John-High-Sierra/sprinkler-8-circuitboard/schematics/SprinKlr8_Board_Design_Brief.docx

SprinKlr-8

8-Zone WiFi Sprinkler Controller

AI CIRCUIT BOARD DESIGN BRIEF

Version 1.0 | May 2026

This document is a complete design brief for the SprinKlr-8 printed circuit board. It specifies every functional block, component, GPIO assignment, power architecture, protection circuit, PCB layout rule, and manufacturing requirement. Design the schematic and PCB layout exactly as specified. Where a choice is not specified, prefer the most reliable and manufacturable option for a commercial product targeting 1,000 units through JLCPCB PCBA.

# 1. Project Overview

SprinKlr-8 is a commercial WiFi-enabled sprinkler controller based on the ESP32 microcontroller. It controls eight 24VAC sprinkler valve solenoids via relay outputs, delivers a browser-based scheduling interface over WiFi, and supports over-the-air (OTA) firmware updates. The board is intended for residential and light commercial irrigation systems.

Field | Value
Product Name | SprinKlr-8
MCU | ESP32-WROOM-32E (38-pin, integrated antenna)
Relay Zones | 8 independent SPST-NO relay outputs for 24VAC solenoid valves
Field Power Input | 24VAC from external transformer — barrel jack (primary) or screw terminal (alternate), user-selectable via on-board jumper
Programming Interface | USB-C (CH340C), auto-reset circuit included
Target Manufacture | JLCPCB PCBA — all SMD components from LCSC catalog
Target Volume | 1,000 units per production run
PCB | 2-layer FR4, 1.6mm, ENIG surface finish
Mounting | Four M3 mounting holes at corners for standoff mounting inside enclosure

# 2. Functional Block Descriptions

The board consists of seven functional blocks. Each is described in full detail below. Design the schematic with these as logical groupings.

## 2.1 Power Supply Block

The board is powered from a 24VAC external transformer — the same transformer used to power the sprinkler valve solenoids. The power supply block converts this AC input to regulated +5V DC (for relay coils, LED drivers, and the CH340C) and +3.3V DC (for the ESP32 and logic).

Power Input Connectors:

- Barrel Jack: Standard 2.1mm centre pin, 5.5mm outer diameter. AC input — the jack is not polarised (24VAC has no polarity). This is the primary power connector for new installations where a dedicated plug-pack transformer is used.
- Screw Terminal: 2-pin, 3.5mm pitch, labelled AC1 and AC2. This allows users to connect the bare wire leads from an existing irrigation transformer. Both terminals are electrically equivalent — 24VAC has no polarity.
- Source Selection Jumper: A 3-pin header (2.54mm pitch) labelled PWR-SEL. Shorting pins 1-2 connects the barrel jack to the AC bus. Shorting pins 2-3 connects the screw terminal to the AC bus. This allows the user to select the active power source. Only one source should be connected at a time. Label the jumper positions clearly on the silkscreen.

WARNING: Both power inputs connect the same AC bus. Never connect both sources simultaneously. Ensure silkscreen labelling and user documentation make this clear.

AC to DC Conversion:

- Full-wave bridge rectifier: Use a MB10F SMD bridge rectifier (LCSC: C441951 or equivalent). Rated 1A, 1000V. Input: 24VAC. Output: approximately +33V DC (peak of 24VAC x 1.414 = 33.9V).
- Filter capacitor: 470 µF, 50V electrolytic (radial, SMD or through-hole depending on availability). Place as close as possible to the rectifier output.
- Inrush protection: 5A polyfuse (resettable fuse) on the AC input line before the bridge rectifier to protect against fault conditions.

+5V DC Rail (Buck Converter):

A linear regulator cannot efficiently step down from ~33V DC to 5V at any meaningful current — the power dissipation would be excessive and would require heatsinking. Use a buck (switching) converter.

- IC: MP2307DN or equivalent buck converter. Input up to 23V — STOP. The rectified 24VAC peak is approximately 34V. Use a buck converter rated for at least 40V input. Recommended: LM2596S-5.0 (input up to 40V, fixed 5V output, 3A, LCSC: C2621). Alternatively use the adjustable LM2596S-ADJ set to 5V output.
- Output: 5.0V regulated DC, minimum 1A capacity.
- Inductor: 100 µH per LM2596 datasheet (through-hole or SMD — use whatever JLCPCB can assemble).
- Output capacitor: 220 µF electrolytic.
- Catch diode: 1N5822 Schottky (3A, 40V) or LCSC equivalent.

+3.3V DC Rail (Linear Regulator):

- IC: AMS1117-3.3 SOT-223 package (LCSC: C6186).
- Input: +5V rail from buck converter.
- Output: 3.3V regulated DC for ESP32 and all logic signals.
- Input capacitor: 10 µF ceramic.
- Output capacitor: 22 µF ceramic.

NOTE: The 24VAC supply from the transformer ALSO connects to the relay contact Common terminal (see Section 2.4). The relay contacts switch the 24VAC to the solenoid valves. This is separate from the board power supply — the 24VAC is both the power source for board electronics AND the switching voltage for the valves.

## 2.2 Microcontroller (ESP32-WROOM-32E)

The ESP32-WROOM-32E is a module with the ESP32 chip, flash memory, and PCB antenna integrated. Mount it on the board using its castellated edge pads.

- Module: ESP32-WROOM-32E, 38-pin, 4MB flash minimum. LCSC: C701341 or equivalent.
- Power: +3.3V supply to VCC pins. Decouple with 10 µF + 100 nF ceramic capacitors as close as possible to the module power pins.
- Enable pin (EN): Pull up to 3.3V via 10 kΩ resistor. Connect a normally-open push button from EN to GND labelled "RST" on the silkscreen.
- Boot mode pin (IO0): Pull up to 3.3V via 10 kΩ resistor. Connect a normally-open push button from IO0 to GND labelled "BOOT" on the silkscreen. IO0 = LOW during reset enters bootloader mode for programming.
- GPIO12 (strapping pin): CRITICAL — connect a 10 kΩ resistor from GPIO12 to GND. GPIO12 must be LOW at boot or the ESP32 will fail to start if SDIO voltage selection is triggered. This is non-negotiable.
- Antenna keep-out: Maintain a copper-free zone of at least 15mm around the on-module PCB antenna area. No copper pours, traces, or components under the antenna.

GPIO Assignments — do not deviate from this mapping:

GPIO | Function | Notes
GPIO32 | Relay Zone 1 | Output → ULN2803A input 1
GPIO33 | Relay Zone 2 | Output → ULN2803A input 2
GPIO25 | Relay Zone 3 | Output → ULN2803A input 3
GPIO26 | Relay Zone 4 | Output → ULN2803A input 4
GPIO27 | Relay Zone 5 | Output → ULN2803A input 5
GPIO14 | Relay Zone 6 | Output → ULN2803A input 6
GPIO12 | Relay Zone 7 | Output → ULN2803A input 7. ALSO has 10kΩ pull-down to GND (strapping pin)
GPIO13 | Relay Zone 8 | Output → ULN2803A input 8
GPIO23 | Status LED | Output → LED + 330Ω resistor to GND. Active HIGH.
GPIO1 (TX0) | UART TX | → CH340C RXD
GPIO3 (RX0) | UART RX | ← CH340C TXD
GPIO0 (IO0) | Boot select | 10kΩ pull-up. Boot button to GND. CH340C auto-reset circuit.
EN | Reset | 10kΩ pull-up. Reset button to GND. CH340C auto-reset circuit.

## 2.3 USB-C Programming Interface (CH340C)

The CH340C provides USB-to-UART conversion for programming and serial monitoring. It has an internal oscillator so no external crystal is needed — do not add a crystal.

- IC: CH340C SOP-16 package. LCSC: C84681.
- USB Connector: USB Type-C receptacle, 16-pin SMD. LCSC: C165948 or equivalent.
- CC1 and CC2 pins on the USB-C connector: Connect each to GND through a 5.1 kΩ resistor. This is mandatory for USB-C power delivery specification compliance and tells the host that the device is a standard downstream device. Without these resistors, many USB-C hosts will not supply power.
- USB ESD Protection: Place a USBLC6-2SC6 (SOT-23-6, LCSC: C2827693) between the USB-C connector D+/D- pins and the CH340C USB pins. This protects against electrostatic discharge on the USB connector.
- VBUS polyfuse: 500mA resettable polyfuse (PTC) in series with the USB VBUS line before the +5V bus. LCSC: C386618 or equivalent. This protects the board if the USB host limits current.
- Decoupling: 100 nF ceramic capacitor from CH340C VCC to GND, placed as close as possible to the IC power pin.

Auto-Reset Circuit (for programming without manual button pressing):

Arduino IDE and esptool automatically reset the ESP32 into bootloader mode before uploading. Two NPN transistors implement this using the CH340C DTR and RTS signals.

- Q1: MMBT3904 NPN transistor (SOT-23). Base connected to CH340C RTS pin through 10 kΩ resistor. Collector connected to ESP32 EN pin. Emitter to GND.
- Q2: MMBT3904 NPN transistor (SOT-23). Base connected to CH340C DTR pin through 10 kΩ resistor. Collector connected to ESP32 IO0 pin. Emitter to GND.
- 100 nF capacitors from each transistor base to GND for noise suppression.

NOTE: This is the standard CH340-based auto-reset circuit used on ESP32 development boards such as the AZ-Delivery ESP32 DevKit. Replicate that circuit exactly.

## 2.4 Relay Driver and Relay Block

Eight SPST-NO relays switch 24VAC to the solenoid valve zones. A ULN2803A Darlington array drives the relay coils from the ESP32 GPIOs. The relay logic is ACTIVE HIGH — relay turns ON when the GPIO is driven HIGH.

Relay Driver IC:

- IC: ULN2803A, SOP-18 package. LCSC: C56026. This is an 8-channel Darlington array with internal flyback (freewheeling) diodes. It can sink up to 500mA per channel.
- Input pins 1-8: Connect to ESP32 GPIO32, 33, 25, 26, 27, 14, 12, 13 respectively. No additional pull-down needed — the ULN2803A inputs are internally clamped.
- COM pin (pin 9): Connect to +5V. This is the flyback diode return rail. It must be connected to the relay coil supply voltage for the internal diodes to clamp coil voltage spikes. CRITICAL — do not leave this pin floating.
- Output pins (collector outputs): Connect to the relay coil negative terminal. The ULN2803A sinks current when input is HIGH.
- GND pin: Connect to board GND.

Relay:

- Part: HF46F-G/5-HS1. SMD relay, SPST-NO, 5V coil, 5A/250VAC contact rating. LCSC: C165255. This is a G5NB-compatible SMD footprint.
- Coil positive terminal: Connect to +5V rail.
- Coil negative terminal: Connect to the corresponding ULN2803A collector output.
- Contact terminals: COM contact connects to the 24VAC Common bus terminal. NO contact connects to the corresponding zone screw terminal.

WARNING: Use exactly LCSC part C165255 (HF46F-G/5-HS1). Do not substitute C128511 (this is a capacitor) or C22363895 (this is a through-hole relay). These are incorrect parts with the same search name.

Zone Output Screw Terminals:

- 8 x 2-pin screw terminal blocks, 3.5mm pitch, rated for 10A/300V. LCSC: C8465 or equivalent. One per relay zone. Label Z1 through Z8 on silkscreen.
- 1 x 2-pin screw terminal block (same type) for the 24VAC Common connection. Label COM on silkscreen. This connects the 24VAC power bus to the relay contact COM terminals.

NOTE: Total screw terminal count: 9 blocks of 2 pins = 18 terminals. Arrange them in a row along one edge of the board for clean wiring. Consider using a 10-pin or two 5-pin blocks if footprint is tighter.

Per-Zone Indicator LEDs:

- 8 x red SMD LEDs (0805 package). One per zone. LCSC: C84256 or equivalent red LED.
- Each LED is connected between the relay coil positive terminal (+5V) and the ULN2803A collector output for that zone, in series with a 470 Ω resistor (0805). When the ULN2803A pulls the collector low (relay ON), current flows through the resistor and LED, illuminating it.
- Place each LED adjacent to its corresponding relay on the PCB for intuitive visual identification.
- LED colour: Zone LEDs = RED. Status LED (GPIO23) = GREEN (see Section 2.5).

## 2.5 Status LED

- 1 x green SMD LED (0805 package). LCSC: C72043 or equivalent.
- Connected from GPIO23 through a 330 Ω resistor (0805) to GND. Active HIGH — LED lights when GPIO23 is driven HIGH.
- Place near the edge of the board or near the ESP32 module. Label "STATUS" on silkscreen.

## 2.6 Relay Output Protection (MOV Snubbers)

Sprinkler solenoid valves are inductive loads. When the relay opens (valve turns off), the collapsing magnetic field in the solenoid coil generates a voltage spike that can exceed 100V, damaging relay contacts over time and causing radiated EMI. Each relay output must be protected.

- Protection device: Metal Oxide Varistor (MOV) rated for 34V AC / 48V DC clamping. Suitable part: TVR05470 (47V, 0.1W, 5mm disc). LCSC equivalent or similar — search LCSC for MOV 47V or 40V disc.
- Connection: Solder the MOV across the relay NO output screw terminal and the COM terminal — i.e., directly across the 24VAC solenoid load. One per zone = 8 MOVs total.
- Alternatively, RC snubbers (100 Ω + 10 nF in series across the contacts) are acceptable if MOVs are unavailable from LCSC. Both can be used together for extra protection.

NOTE: MOVs on the relay contacts protect against load-side spikes. The ULN2803A internal flyback diodes protect against coil-side spikes on the 5V rail. Both types of protection are present in this design.

## 2.7 Miscellaneous Connectors and Components

Mounting Holes:

- Four M3 plated through-hole mounting holes, one at each corner of the board. Minimum clearance of 5mm from all traces and copper. Use standard M3 hole diameter (3.2mm) with a 6.5mm annular copper ring.

Decoupling Capacitors:

- Place 100 nF ceramic decoupling capacitors (0402 or 0603) on the power supply pins of every IC — CH340C, ULN2803A, and AMS1117. Place physically as close to each IC power pin as possible.

Test Points:

- Expose test points (THT or SMD pads labelled with net names) for: +5V rail, +3.3V rail, GND, ESP32 TX, ESP32 RX, and USB VBUS. Useful during bring-up.

# 3. Bill of Materials

All components must be available on LCSC and preferably classified as "Basic" parts to minimise JLCPCB extended component fees. LCSC part numbers are provided where confirmed correct. Verify all part numbers in EasyEDA/LCSC before ordering.

Component / Description | LCSC Part | Package | Qty | Notes
ESP32-WROOM-32E | C701341 | Module | 1 | 4MB flash minimum
CH340C USB-UART | C84681 | SOP-16 | 1 | Internal oscillator, no crystal needed
AMS1117-3.3 LDO | C6186 | SOT-223 | 1 | 3.3V regulator
LM2596S-5.0 Buck Converter | C2621 | TO-263-5 | 1 | 5V/3A, 40V input max
MB10F Bridge Rectifier | C441951 | MBS | 1 | 1A, 1000V SMD bridge
ULN2803A Darlington Array | C56026 | SOP-18 | 1 | 8-ch, internal flyback diodes
HF46F-G/5-HS1 Relay, 5V SMD | C165255 | SMD | 8 | SPST-NO, 5A/250VAC, G5NB footprint
USBLC6-2SC6 USB ESD Protection | C2827693 | SOT-23-6 | 1 | On USB D+/D- lines
MMBT3904 NPN Transistor | C20526 | SOT-23 | 2 | Auto-reset circuit (DTR/RTS)
USB Type-C Receptacle 16-pin | C165948 | SMD | 1 | Verify footprint in EasyEDA
Barrel Jack 2.1mm/5.5mm | Verify on LCSC | THT | 1 | 24VAC primary power input
2-pin Screw Terminal 3.5mm | C8465 | THT | 9 | 8 zone outputs + 1 COM
2-pin Screw Terminal 3.5mm | C8465 | THT | 1 | Alternate 24VAC input from screw
3-pin Header 2.54mm (PWR-SEL) | Standard | THT | 1 | Power source selection jumper
MOV 47V disc (per-zone protection) | Verify on LCSC | Disc 5mm | 8 | Across relay NO and COM output
Red LED 0805 | C84256 | 0805 | 8 | Per-zone relay indicators
Green LED 0805 | C72043 | 0805 | 1 | System status (GPIO23)
470 Ω Resistor 0805 | Basic | 0805 | 8 | Zone LED current limit
330 Ω Resistor 0805 | Basic | 0805 | 1 | Status LED current limit
10 kΩ Resistor 0402 | Basic | 0402 | 8 | Pull-ups (EN, IO0) + GPIO12 pull-down + auto-reset bases
100 nF Ceramic Cap 0402 | Basic | 0402 | 10 | Decoupling on all IC power pins
10 µF Ceramic Cap 0603 | Basic | 0603 | 3 | AMS1117 input/output, ESP32 power
470 µF Electrolytic 50V | Verify on LCSC | Radial | 1 | Bulk filter cap after bridge rectifier
220 µF Electrolytic 10V | Verify on LCSC | Radial | 1 | LM2596 output filter cap
100 µH Inductor | Verify on LCSC | SMD or THT | 1 | LM2596 switching inductor, rated 1A+
1N5822 Schottky Diode | Verify on LCSC | DO-201AD or SMD | 1 | LM2596 catch diode
5.1 kΩ Resistor 0402 | Basic | 0402 | 2 | USB-C CC1 and CC2 to GND
500mA PTC Polyfuse | C386618 | 0805 | 1 | USB VBUS protection
5A PTC Polyfuse (AC input) | Verify on LCSC | THT or SMD | 1 | AC line protection before bridge rectifier
BOOT Push Button (6mm) | C318884 | THT | 1 | IO0 to GND
RST Push Button (6mm) | C318884 | THT | 1 | EN to GND

# 4. PCB Layout Rules and Guidelines

Follow these rules strictly. They are based on electrical performance requirements, safety standards, and JLCPCB manufacturing capabilities.

## 4.1 Board Specifications

- Layers: 2 (top copper + bottom copper)
- Board material: FR4
- Thickness: 1.6mm
- Surface finish: ENIG (Electroless Nickel Immersion Gold) — required for a commercial product. Better solderability and longer shelf life than HASL.
- Minimum trace width: 0.15mm (JLCPCB standard). Use wider traces wherever possible.
- Minimum via: 0.3mm drill, 0.6mm pad (JLCPCB standard).
- Copper weight: 1oz top and bottom.
- Solder mask: Green (standard). Both sides.
- Silkscreen: White both sides. Include all component reference designators, pin 1 markers, connector labels (Z1-Z8, COM, AC1, AC2), and a board revision/version number.

## 4.2 Board Size

The board must accommodate the ESP32 module (18mm x 25.5mm), 8 relays, 9 screw terminal blocks, power supply section, and USB connector. Estimated minimum board size is 100mm x 80mm. Adjust as needed to fit all components comfortably with required clearances. Target a board size that will fit in a standard ABS project enclosure (e.g., 130mm x 100mm x 40mm internal).

## 4.3 Component Placement

- ESP32 module: Top side. Orient antenna toward a board edge with no copper within 15mm of the antenna. Do not place it in a corner — the antenna must face away from the power section.
- Relay block: Group all 8 relays together in two rows of 4. Place close to the screw terminal edge.
- Screw terminals: Along one long edge of the board (the "field wiring" edge). Zone terminals Z1-Z8 in order, followed by COM. The alternate 24VAC input screw terminal can be near the barrel jack on the "power" edge.
- Power supply block (bridge rectifier, LM2596, AMS1117): Opposite edge from the relay/terminal side. Keep high-voltage AC traces short and away from the ESP32 and USB section.
- USB-C connector: On the short edge of the board, accessible from outside an enclosure.
- BOOT and RST buttons: Near the ESP32 module, accessible without tools.
- Zone LEDs: Adjacent to their corresponding relay. Oriented consistently (all anode to +5V side).
- Status LED: Near the ESP32 module, near the board edge for visibility.
- ULN2803A: Between the ESP32 GPIO outputs and the relay coils. Place centrally in the relay block area.
- MOVs: As close as possible to the screw terminal output connections.

## 4.4 Trace Widths

Net / Signal | Min Width | Notes
24VAC input (before rectifier) | 1.5mm | Mains AC potential
Relay contact traces (COM, zone outputs) | 1.5mm | 5A rated — keep as short as possible
+5V power bus | 0.8mm | Up to 1A
+3.3V power bus | 0.5mm | ESP32 supply
GND pour (plane) | Copper fill | Flood fill on both layers
GPIO signal traces (relay control) | 0.25mm | Low current logic
USB data lines (D+, D-) | 0.2mm | Match impedance, keep equal length, keep short
UART (TX/RX) | 0.2mm | Keep away from switching supply

## 4.5 Clearances

- Minimum clearance between AC traces (24VAC section) and all low-voltage DC traces: 3mm. This is a safety isolation requirement.
- Relay contact side (NO terminal traces carrying 24VAC) to DC logic traces: 3mm minimum clearance.
- General PCB design rule clearance (non-HV): 0.2mm minimum (JLCPCB capability is 0.127mm but use 0.2mm for reliability).
- Mounting hole copper clearance: 5mm from all traces.
- Board edge clearance: minimum 0.3mm for all copper, 0.5mm for components.

## 4.6 Copper Pour / Ground Plane

- Flood fill GND on both top and bottom copper layers.
- Stitch top and bottom GND pours together with via stitching (multiple vias around the perimeter and under large copper areas).
- Do NOT flood fill GND under the ESP32 antenna area. Keep that zone copper-free.
- Separate the AC power section ground from the DC logic ground — use a single connection point (star ground) between the two to prevent AC noise coupling into the logic section.

## 4.7 Switching Power Supply Layout (LM2596)

- Keep the switching loop (LM2596 output pin → catch diode → inductor → output capacitor → GND back to IC) as tight and short as possible. Switching current loops must be minimised to reduce EMI.
- Place the catch diode directly adjacent to the LM2596 output pin.
- Place the inductor and output capacitor close together.
- Do not route sensitive signal traces (UART, USB, GPIO) near the LM2596 switching loop.

# 5. Manufacturing Requirements (JLCPCB PCBA)

## 5.1 File Outputs Required

- Gerber files (RS-274X format): All copper layers, solder mask, silkscreen, board outline, drill.
- Drill file: Excellon format, with separate PTH and NPTH files if applicable.
- BOM CSV: Component reference, LCSC part number, quantity, footprint, value. Format must match JLCPCB BOM template.
- Pick and Place CSV (CPL): Component reference, centre X, centre Y, rotation, layer. Format must match JLCPCB CPL template.

## 5.2 JLCPCB PCBA Notes

- All components specified as SMD should be on the TOP side of the board where possible to avoid double-sided assembly surcharges.
- Through-hole components (screw terminals, barrel jack, push buttons, electrolytic capacitors, inductors) may be excluded from PCBA and hand-assembled after reflow. Flag these clearly in the BOM.
- Use LCSC "Basic" parts wherever possible. Extended parts add a $3 setup fee per part type. Check LCSC classification before finalising BOM.
- Verify all component footprints against LCSC datasheet mechanical drawings before submitting. Incorrect footprints are the most common cause of PCBA rework.
- Include fiducial marks (3 minimum) on the top copper layer for pick-and-place alignment.
- JLCPCB minimum order for PCBA is typically 5 boards — order 5 for initial prototyping.

## 5.3 Prototype Verification Sequence

1. Power on with USB only (no 24VAC). Confirm 3.3V and 5V rails are present. Check CH340C is detected by a PC as a COM port.
2. Flash relay_pin_finder firmware via Arduino IDE. Confirm each GPIO activates the correct relay in sequence (GPIO32=zone1 through GPIO13=zone8).
3. Connect 24VAC. Confirm bridge rectifier output is approximately 30-34V DC. Confirm LM2596 output is 5.0V. Confirm AMS1117 output is 3.3V.
4. Flash main sprinkler_controller firmware. Confirm WiFi AP "SprinklerSetup" appears. Configure WiFi. Confirm board connects and web interface loads at http://sprinkler.local.
5. Test each zone from the web interface. Confirm zone LED illuminates and relay clicks.
6. Verify mDNS is working (http://sprinkler.local resolves without IP address).

# 6. Firmware Context (For Reference Only)

The firmware is pre-written and is not part of this design brief. The following information is provided so the board designer understands the software environment and can verify the hardware supports it correctly.

- Platform: Arduino IDE 2.x with ESP32 Arduino core (Espressif).
- Libraries: WiFiManager (tzapu), ArduinoJson (bblanchon), NTPClient (Weinberg), ESPAsyncWebServer, LittleFS.
- WiFi provisioning: Captive portal via WiFiManager. SSID: "SprinklerSetup". After provisioning, connects to user WiFi.
- Web interface: Served from LittleFS (internal flash filesystem). Single-page app, mobile-optimised, dark theme.
- mDNS: Board advertises as "sprinkler.local" using ESPmDNS library. Reachable at http://sprinkler.local without knowing the IP address.
- OTA updates: Arduino OTA and HTTP OTA from GitHub releases.
- Relay logic: ACTIVE HIGH. GPIO HIGH = relay coil energised = valve ON.
- All 8 relay GPIO pins are confirmed in firmware as: GPIO32, 33, 25, 26, 27, 14, 12, 13 for zones 1-8.
- Status LED on GPIO23: slow heartbeat when idle, fast blink when a zone is running.

# 7. Design Intent Summary

This section summarises the intent behind key design decisions for the benefit of the AI designer.

Decision | Rationale
24VAC power input (not 5V/12V DC) | Residential sprinkler systems already have a 24VAC transformer. Using the existing transformer reduces installation cost and complexity for the end user.
Barrel jack + screw terminal with jumper | New installations use a small plug-pack transformer into the barrel jack. Users replacing an existing controller can reuse their existing wired transformer via screw terminals. The jumper prevents both being active simultaneously.
USB-C with auto-reset | Modern connector. Auto-reset eliminates the need for the user to manually hold buttons during firmware flashing — critical for a non-technical end user. Developer-friendly.
ULN2803A + HF46F-G relay (not solid state) | Mechanical relays provide hard galvanic isolation between 24VAC and ESP32 logic. Simple, robust, low-cost, and compatible with inductive solenoid loads.
MOV output protection | Solenoid valve coils are inductive. Without protection, the back-EMF spike when a valve turns off can damage relay contacts over hundreds of cycles and cause radiated interference.
Per-zone red LEDs | Instant visual feedback during installation and troubleshooting. An installer can see which zone is firing without a phone or web browser.
GPIO12 pull-down resistor | GPIO12 is the ESP32 SDIO voltage strapping pin. If high at boot, the chip selects a different flash voltage and may fail to start. The 10kΩ pull-down ensures reliable boot in all conditions.
LM2596 buck converter (not linear) | Stepping 34V DC down to 5V with a linear regulator would dissipate ~29V at whatever current the board draws — generating significant heat and requiring a heatsink. The switching converter is >80% efficient and stays cool.
M3 mounting holes at corners | Board will be mounted inside an ABS plastic enclosure on nylon or brass standoffs. Screw mounting is standard for commercial enclosures and provides mechanical stability and vibration resistance.

End of Design Brief

For firmware, web UI, and product documentation, refer to the SprinKlr-8 project repository.

SprinKlr-8 PCB Design Brief | Rev 1.0 | 2026 Page

SprinKlr-8 | AI Board Design Brief CONFIDENTIAL
