John-High-Sierra/sprinkler-8-circuitboard/hardware/Rev0.2/SprinKlr-8 Rev1.1/SprinKlr-8 Rev1.1/3D RENDER/SprinKlr-8 Rev1.0.pdf

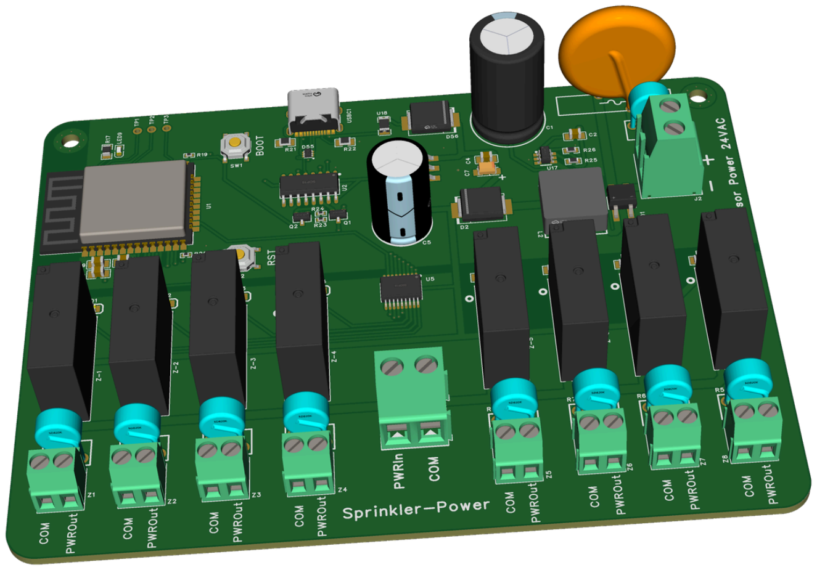
[picture p1: page 1]
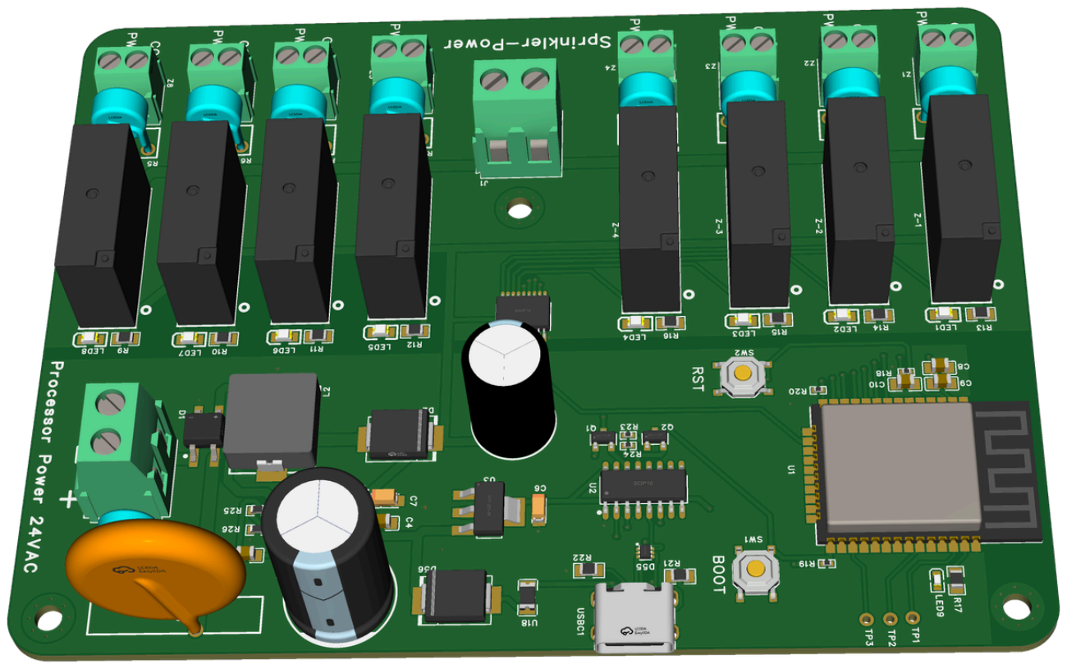
[picture p2: page 2]
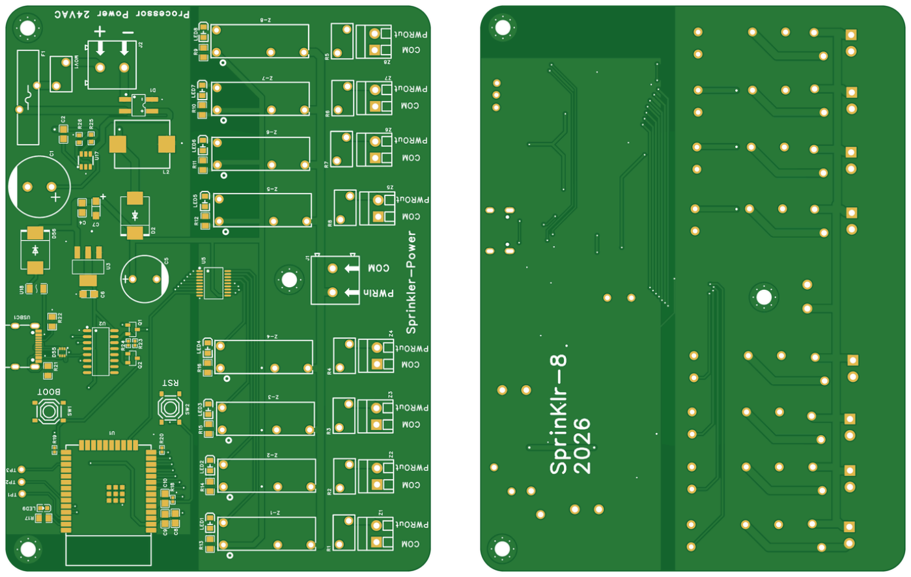
[picture p3: page 3]
