John-High-Sierra/sprinkler-8-circuitboard/schematics/Rough Arrangement.jpg

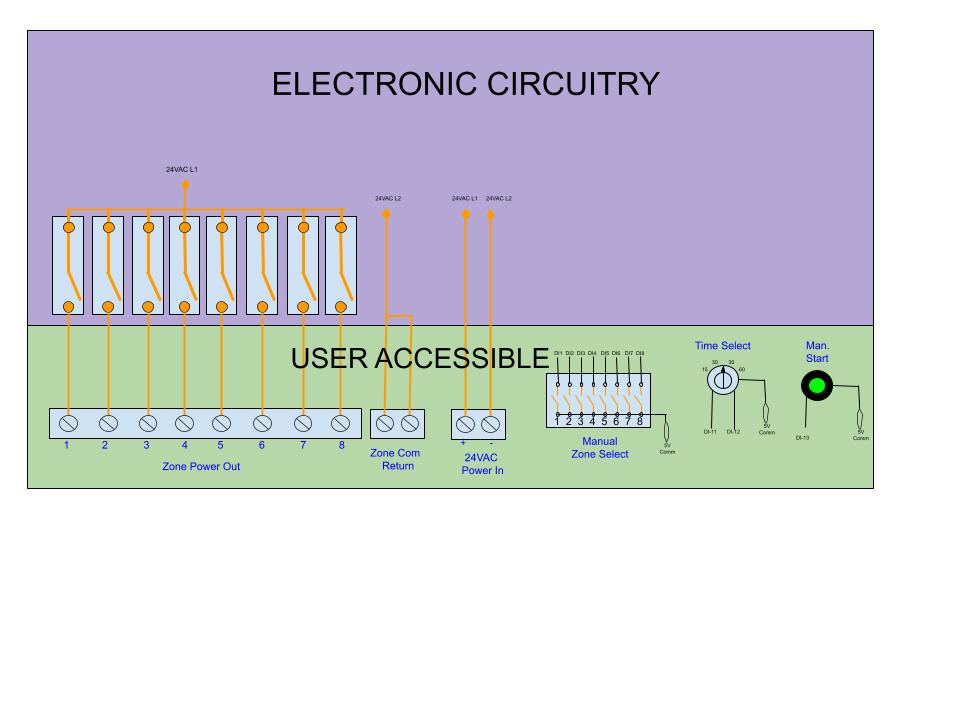
schematics/Rough Arrangement.jpg
