John-High-Sierra/sprinkler-8-circuitboard/hardware/Rev0.2/SprinKlr-8 Rev1.1/SprinKlr-8 Rev1.1/BOM/BOM.csv

No. | Quantity | Comment | Designator | Footprint | Value | Manufacturer Part | Manufacturer | Supplier Part | Supplier
1 | 1 | 470uF | C1 | CAP-TH_BD13.0-P5.00-D1.2-FD | 470uF | ERF1HM471K16OT | AISHI(艾华集团) | C106527 | LCSC
2 | 4 | 100nF | C2,C4,C9,C10 | C0805 | 100nF | CL21B104KCFNNNE | SAMSUNG(三星) | C28233 | LCSC
3 | 1 | 220uF | C5 | CAP-TH_BD10.0-P5.00-D1.0-FD | 220uF | SHG220UF50V01EC1210 | KNSCHA(科尼盛) | C3034843 | LCSC
4 | 1 | 22uF | C6 | CASE-A_3216 | 22uF | TAJA226K010RNJ | Kyocera AVX | C11366 | LCSC
5 | 1 | 10uF | C7 | CAP-SMD_L3.2-W1.6-RD-C7171 | 10uF | TAJA106K016RNJ | Kyocera AVX | C7171 | LCSC
6 | 1 | 10uF | C8 | C0805 | 10uF | CL21A106KAYNNNE | SAMSUNG(三星) | C15850 | LCSC
7 | 1 | MB210S | D1 | MBS_L4.7-W4.0-P2.50-LS7.0-BL |  | MB210S | 晶导微电子 | C382839 | LCSC
8 | 2 | SS35 | D2,D56 | SMC_L6.9-W5.9-LS7.9-RD |  | SS35 | onsemi(安森美) | C719834 | LCSC
9 | 1 | USBLC6-2P6 | D55 | SOT-666-6_L1.6-W1.2-P0.50-LS1.6-BL |  | USBLC6-2P6 | TECH PUBLIC(台舟) | C2827693 | LCSC
10 | 1 | RL250-800 | F1 | FUSE-TH_L20.0-W4.5-P5.10-D0.8-S3.70 |  | RL250-800 | RUILON(瑞隆源) | C20866 | LCSC
11 | 2 | WJ500V-5.08-2P | J1,J2 | CONN-TH_2P-P5.00_WJ500V-5.08-2P |  | WJ500V-5.08-2P | KANGNEX(康奈克斯电气) | C8465 | LCSC
12 | 1 | 100uH | L2 | IND-SMD_L11.5-W10.0 | 100uH | PSPMAA1050H-101M-ANP | PROD(谱罗德) | C5273830 | LCSC
13 | 8 | NCD0805R1 | LED1,LED2,LED3,LED4,LED5,LED6,LED7,LED8 | LED0805-RD |  | NCD0805R1 | 国星光电 | C84256 | LCSC
14 | 1 | 19-217/GHC-YR1S2/3T | LED9 | LED0603-RD |  | 19-217/GHC-YR1S2/3T | EVERLIGHT(亿光) | C72043 | LCSC
15 | 9 | 250pF@1kHz | MOV1,R1,R2,R3,R4,R5,R6,R7,R8 | RES-TH_L7.5-W4.6-P5.00-D1.2-S2.00 | 250pF@1kHz | STE05D101K1BN0FSB0R0 | STE(松田) | C362788 | LCSC
16 | 2 | MMBT3904 | Q1,Q2 | SOT-23-3_L2.9-W1.3-P1.90-LS2.4-BR |  | MMBT3904 | CJ(江苏长电/长晶) | C20526 | LCSC
17 | 8 | 470Ω | R9,R10,R11,R12,R13,R14,R15,R16 | R0805 | 470Ω | 0805W8F4700T5E | UNI-ROYAL(厚声) | C17710 | LCSC
18 | 1 | 330Ω | R17 | R0805 | 330Ω | 0805W8F3300T5E | UNI-ROYAL(厚声) | C17630 | LCSC
19 | 5 | 10kΩ | R18,R19,R20,R23,R24 | R0402 | 10kΩ | 0402WGF1002TCE | UNI-ROYAL(厚声) | C25744 | LCSC
20 | 2 | 5.1kΩ | R21,R22 | R0805 | 5.1kΩ | 0805W8F5101T5E | UNI-ROYAL(厚声) | C27834 | LCSC
21 | 1 | 43kΩ | R25 | R0603 | 43kΩ | FRC0603F4302TS | FOJAN(富捷) | C2907038 | LCSC
22 | 1 | 13kΩ | R26 | R0603 | 13kΩ | FRC0603F1302TS | FOJAN(富捷) | C2906992 | LCSC
23 | 2 | TS-1187A-B-A-B | SW1,SW2 | SW-SMD_4P-L5.1-W5.1-P3.70-LS6.5-TL_H1.5 |  | TS-1187A-B-A-B | XKB Connection(中国星坤) | C318884 | LCSC
24 | 1 | 2.4GHz | U1 | WIFI-SMD_ESP32-WROOM-32E | 2.4GHz | ESP32-WROOM-32E-N4 | ESPRESSIF(乐鑫) | C701341 | LCSC
25 | 1 | CH340C | U2 | SOP-16_L10.0-W3.9-P1.27-LS6.0-BL |  | CH340C | WCH(南京沁恒) | C84681 | LCSC
26 | 1 | AMS1117-3.3 | U3 | SOT-223-3_L6.5-W3.4-P2.30-LS7.0-BR |  | AMS1117-3.3 | AMS | C6186 | LCSC
27 | 1 | TBD62083AFNG,EL | U5 | SSOP-18_L6.8-W4.4-P0.65-LS6.4-BL |  | TBD62083AFNG,EL | TOSHIBA(东芝) | C163229 | LCSC
28 | 1 | LMR16006XDDCR | U17 | SOT-23-6_L2.9-W1.6-P0.95-LS2.8-BR |  | LMR16006XDDCR | TI(德州仪器) | C87080 | LCSC
29 | 1 | 1206L050/24NRT | U18 | F1206 |  | 1206L050/24NRT | LUTE(陆特) | C28326720 | LCSC
30 | 1 | TYPE-C-31-M-12 | USBC1 | USB-C_SMD-TYPE-C-31-M-12_1 |  | TYPE-C-31-M-12 | 韩国韩荣 | C165948 | LCSC
31 | 8 | DB125-3.5-2P-GN-S | Z1,Z2,Z3,Z4,Z5,Z6,Z7,Z8 | CONN-TH_2P-P3.50_L7.4-W7.0 |  | DB125-3.5-2P-GN-S | DORABO(地博电气) | C466970 | LCSC
32 | 8 | HF46F-G/5-HS1 | Z-1,Z-2,Z-3,Z-4,Z-5,Z-6,Z-7,Z-8 | RELAYS-TH_HF46F-G-XX-HS1-XXX |  | HF46F-G/5-HS1 | HF(宏发) | C165255 | LCSC
