John-High-Sierra/sprinkler-8-circuitboard/(list of files, cad)

Other CAD files:
case_design/sprinkler_case.scad
