John-High-Sierra/sprinkler-8-circuitboard/hardware/Rev0.2/SprinKlr-8 Rev1.1/SprinKlr-8 Rev1.1/Schematics/Schematic.pdf

# POWER BLOCK MICROCONTROLLER

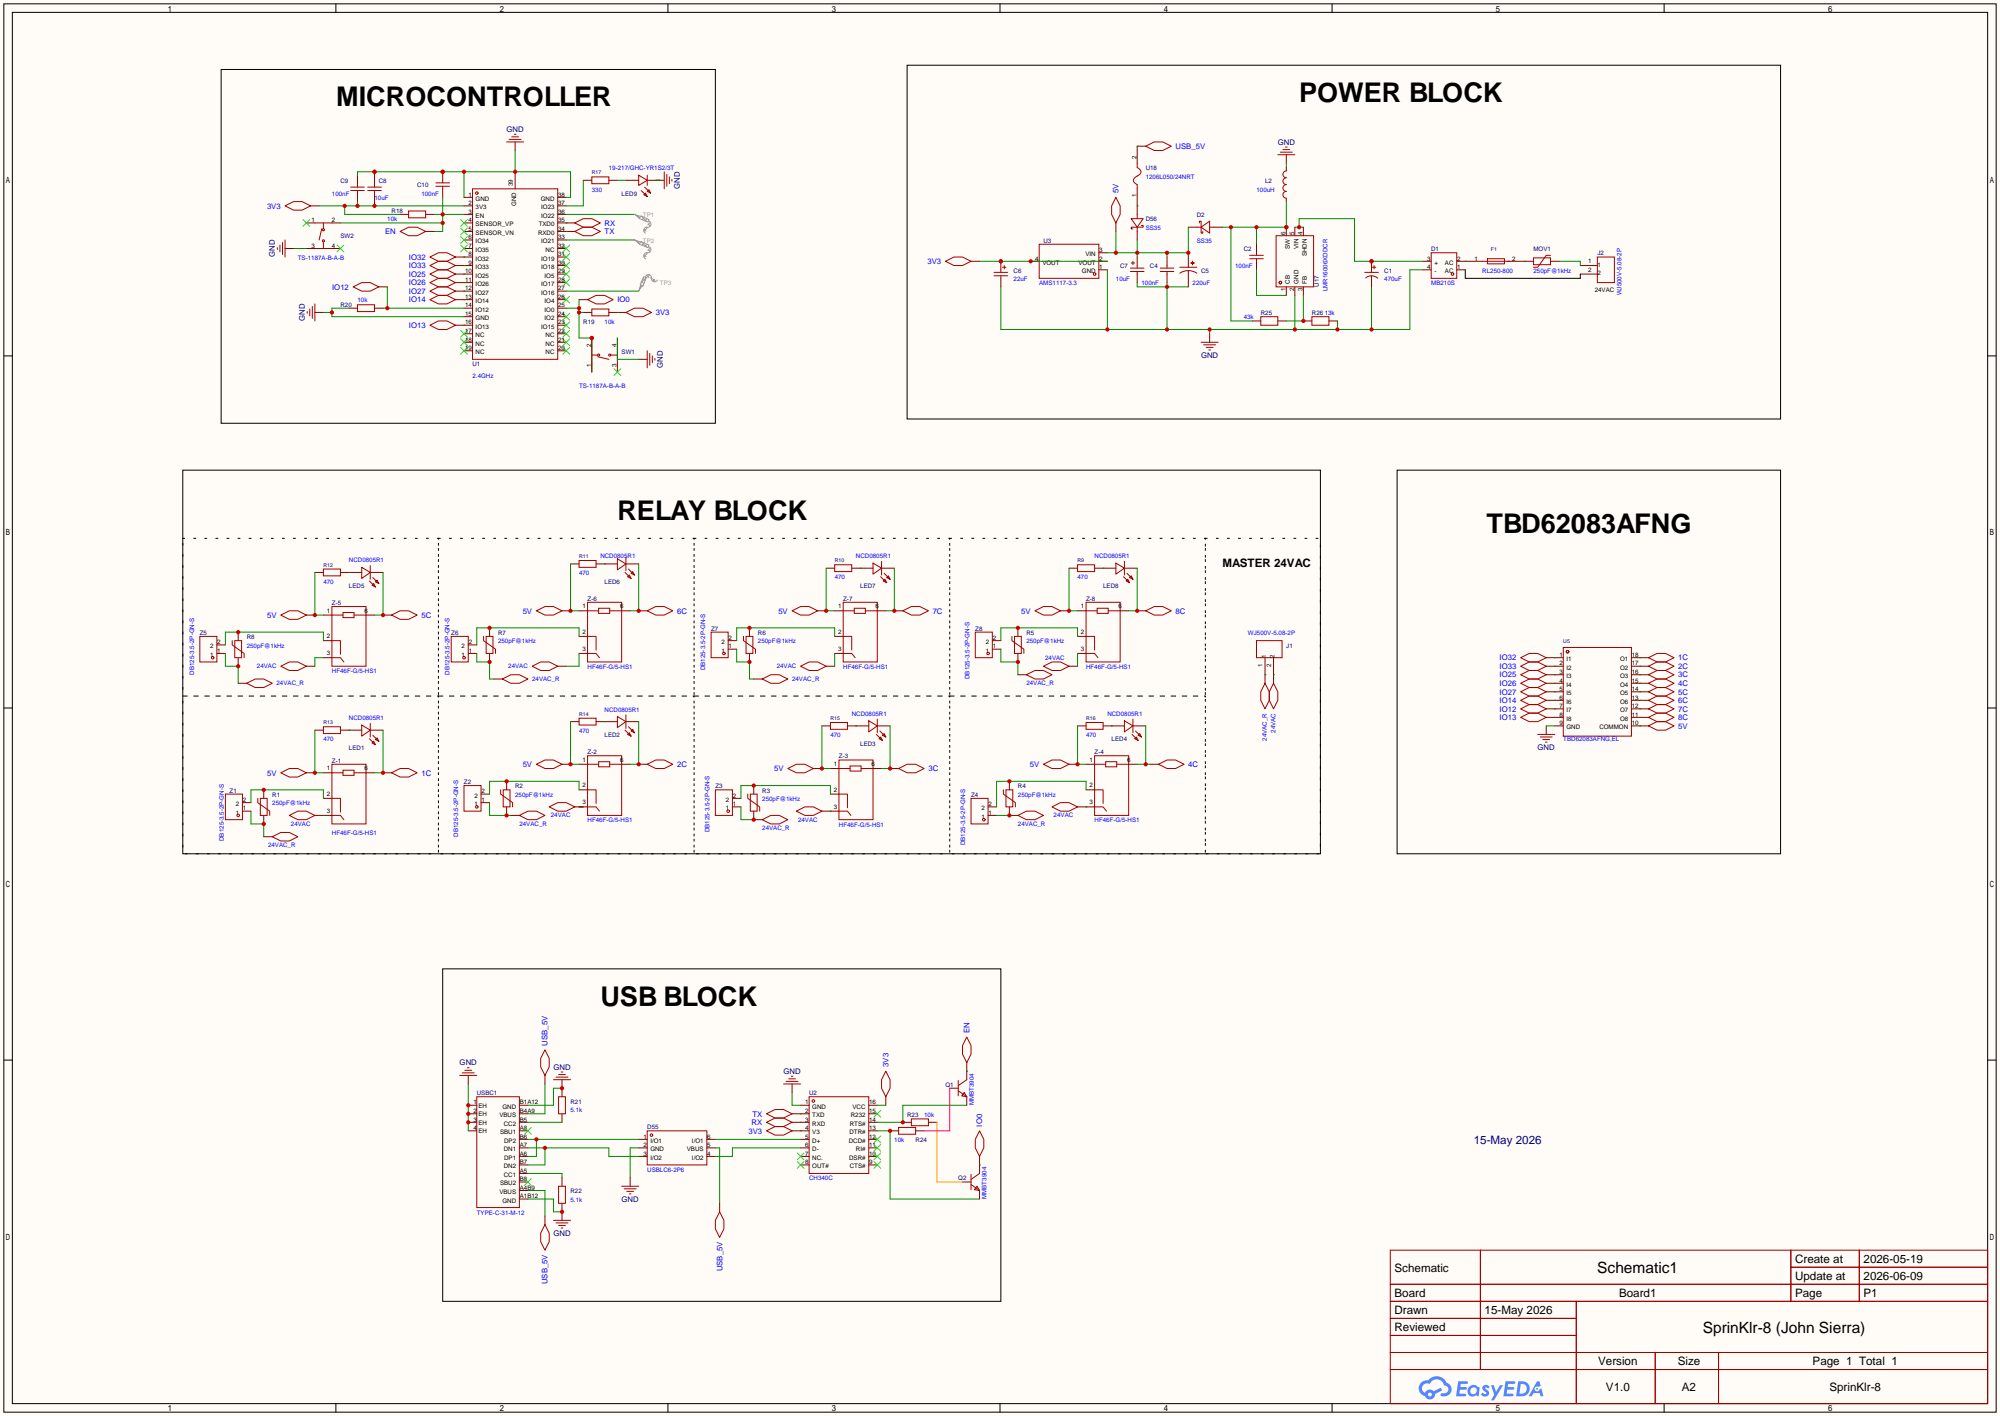
[picture p5: page 1]

DSR# 10 RI# 11 DCD# 12 DTR# 13 RTS# 14 R232 15 VCC 16

GND A1B12 VBUS A4B9 SBU2 B8 CC1 A5 DN2 B7 DP1 A6 DN1 A7 DP2 B6 SBU1 A8 CC2 B5 VBUS B4A9 GND B1A12

Schematic | Schematic1 | Create at | 2026-05-19

Update at | 2026-06-09

Board | Board1 | Page | P1
Drawn | 15-May 2026 | SprinKlr-8 (John Sierra)
Reviewed

Version | Size | Page 1 Total 1
V1.0 | A2 | SprinKlr-8
