John-High-Sierra/sprinkler-8-circuitboard/(list of files, drawings)

Other design files:
hardware/Rev0.1/SprinKlr-8 Rev1.1/SprinKlr-8 Rev1.1/EasyEAD/SprinKlr-8 Rev1.epro
hardware/Rev0.2/SprinKlr-8 Rev1.1/SprinKlr-8 Rev1.1/EasyEAD/SprinKlr-8 Rev1.epro
