John-High-Sierra/sprinkler-8-circuitboard/(commit log)

2026-06-28 Initial commit: Sprinkler-8 board hardware and design files
    [BOM.csv, BOM_R01.csv, PickAndPlace _8.csv, PickAndPlace.csv, SprinKlr-8 Rev1.epro, SprinKlr8_BOM_JLCPCB.csv, sprinkler_case.scad]
2026-06-28 Add Contractor Brief Rev 2: power fusing, zone terminals, DIP/rotary/button controls, case spec
2026-06-29 Add board layout and wiring diagram SVGs for Rev 2
2026-06-29 Add Hobby Board contractor brief Rev 2 (docx) and remove old SprinKlr8 spec docs
2026-07-01 Update contractor brief: relay GPIOs in ascending order, F1/F2 fuses to 500mA
2026-07-01 Move relay Ch1 from GPIO12 to GPIO4; GPIO12 dedicated strapping pull-down only
2026-07-01 Commit MCP23008 for DIP switch, assign all GPIOs, add Section 2.6 expander
